Felix-0901/Smart_Home/README.md

# Smart Home

## 專案簡介

這是高中專題延伸整理的智慧家庭專案。專案目標是讓 K、M、P、R、T 多條硬體產品線收集資料，透過後端寫入 PostgreSQL，再由 App 綁定產品、查看即時與歷史資料，並控制 P 系列智慧插座。

目前階段已包含後端 API、MQTT bridge、硬體韌體整理、React Native / Expo App 與 Homi APP Agent 工具層。

## 功能列表

- 硬體感測資料上傳到後端
- 後端接收、驗證並寫入 PostgreSQL
- APP 註冊登入與 JWT / refresh token
- 透過產品編號綁定 Demo 裝置
- APP 查看即時資料與歷史資料
- APP 控制 P 系列智慧插座 relay
- Homi Agent 可透過受控 action 協助導頁、查詢數據、設定裝置、管理房屋空間、切換偏好、聚焦插座並直接送出 relay 控制
- 本地使用 Docker 啟動 PostgreSQL 測試環境
- 使用 Adminer 或 Docker 內的 `psql` 查看資料庫內容
- 硬體程式碼集中放在 `hardware/`

## 技術架構

- App：放在 `app/`，使用 React Native / Expo + TypeScript + Expo Router，可用 Expo Web 匯出成靜態網站部署
- 後端：放在 `backend/`，使用 Node.js + TypeScript API 服務
- 資料庫：PostgreSQL
- MQTT：Mosquitto，供 P 系列智慧插座接收開關指令與回報狀態
- AI Agent：後端使用 OpenAI-compatible Chat Completions，APP 只執行後端驗證過的 Homi action
- 本地測試：Docker Compose，包含 APP Web、後端 API、PostgreSQL、Mosquitto、Adminer
- APP Web 部署：`app/Dockerfile` 使用 Expo Web build，Nginx 提供靜態檔與 SPA fallback
- 資料庫檢視：Adminer、Docker 內建 `psql`
- 硬體韌體：放在 `hardware/`，後續依板子型號選擇 Arduino CLI、PlatformIO 或廠商工具

## 專案結構

```text
.
├── AGENTS.md
├── README.md
├── app/
├── backend/
├── docs/
├── hardware/
├── infra/
├── docker-compose.yml
└── .env.example
```

## 本地測試教學

先確認 Docker Desktop 已啟動，然後在專案根目錄執行：

```bash
docker compose up -d
```

查看容器狀態：

```bash
docker compose ps
```

後端 API 本地網址：

```text
http://localhost:3003
```

APP Web 本地網址：

```text
http://localhost:3004
```

確認後端與資料庫連線：

```bash
curl http://localhost:3003/health
```

建立 APP 使用者系統與 Demo 裝置需要的資料表：

```bash
cd backend
npm install
npm run db:setup
npm run db:seed-demo-devices
```

若要用 iOS Simulator 啟動 APP：

```bash
cd ../app
npm install
npm run ios
```

若要確認 APP Web production build：

```bash
cd ../app
npm run build:web
```

停止本地服務：

```bash
docker compose down
```

若要連進 PostgreSQL：

```bash
docker compose exec postgres psql -U smart_home -d smart_home
```

進入 `psql` 後常用指令：

```sql
\dt
\d table_name
SELECT * FROM table_name LIMIT 20;
\q
```

若偏好網頁介面，啟動 Docker 後開啟：

```text
http://localhost:8080
```

Adminer 登入資訊：

```text
System: PostgreSQL
Server: postgres
Username: smart_home
Password: smart_home_password
Database: smart_home
```

時間欄位使用台灣時間 `Asia/Taipei` 顯示。`received_at` 保留 PostgreSQL 的 `TIMESTAMPTZ` 型別，方便正確排序與比較；本地 Docker 與後端連線會把時區設為 `Asia/Taipei`，所以查詢時會看到 `+08`。

## 環境變數

環境變數範本放在 `.env.example`。目前 Docker Compose 已設定預設值，所以沒有 `.env` 也可以啟動。

實際開發時可以複製一份 `.env`：

```bash
cp .env.example .env
```

不要提交真正的 `.env`、Token、密碼或憑證。

## Coolify 部署教學

後端已提供 `backend/Dockerfile`，APP Web 已提供 `app/Dockerfile`。若使用根目錄 `docker-compose.yml` 部署，Coolify 會同時建立 APP Web、後端、PostgreSQL、Mosquitto 與 Adminer 服務。

正式部署時建議至少設定兩個公開 domain：

```text
APP Web：https://你的 APP 網域
Backend API：https://你的 API 網域
```

APP Web 的 `EXPO_PUBLIC_API_BASE_URL` 是 build-time 變數，Coolify 重新設定後需要重新 build APP image。正式部署時至少需要設定：

```text
APP_PORT=3004
EXPO_PUBLIC_API_BASE_URL=https://你的 API 網域
DATABASE_URL=postgresql://...
DEVICE_API_TOKEN=正式硬體上傳用 token
CORS_ORIGIN=https://你的 APP 網域
APP_PUBLIC_URL=https://你的 API 網域
APP_JWT_SECRET=至少 32 字元的 APP JWT secret
APP_ACCESS_TOKEN_TTL_SECONDS=900
APP_REFRESH_TOKEN_TTL_DAYS=30
APP_INVITE_CODE=Smart_Home
MQTT_BROKER_URL=mqtt://你的 MQTT broker:1883
AI_ENABLED=true
AI_PROVIDER=openai_compatible
AI_BASE_URL=https://你的 AI endpoint
AI_API_KEY=正式 AI key
AI_MODEL=gpt-5.4
```

不要在正式環境使用 `.env.example` 內的本地預設密碼、token 或 JWT secret。Adminer 只建議本地或內網短暫排錯使用，正式部署不要綁定公開 domain。

正式 domain 確定後，硬體程式碼會把資料上傳到：

```text
https://你的固定 API domain/api/series/{seriesKey}/readings
```

## 前端 / 後端詳細文件連結

- [後端文件](backend/README.md)
- [App 文件](app/README.md)
- [整合規劃文件](docs/README.md)
- [硬體文件](hardware/README.md)
