Felix-0901/Smart_Home/docs/README.md

# Docs

## 模組簡介

`docs/` 用來放跨硬體系列、後端、資料庫與部署流程的補充規劃文件。單一系列的接線、測試結果與燒錄方式仍維護在各自的 `hardware/{series_key}/README.md`。

## 文件列表

- [硬體系列整合規劃](hardware-integration-plan.md)

## 維護原則

- 規劃文件使用繁體中文。
- 不記錄 WiFi 密碼、Token、憑證或正式連線字串。
- 硬體實測結果仍以各系列 README 的變更紀錄為準。
- 若規劃改動會影響腳位、狀態燈、上傳欄位或後端 API，需同步更新相關 README。
