Felix-0901/Smart_Home/(commit log)

2026-05-15 chore: 初始化智慧家庭專案
2026-05-31 feat(m-series): 新增 M 系列硬體測試程式
2026-05-31 feat: 整合硬體系列與 MQTT 後端
2026-06-05 feat(app): 新增智慧家庭 APP 與 APP API
2026-06-05 style(app): 優化底部導航列玻璃效果
2026-06-05 feat(app): 完善帳號管理與互動細節
2026-06-05 feat(app): 優化助理介面與首頁插座清單
2026-06-05 fix(app): 修正助理輸入框自動增高
2026-06-06 feat(agent): 完善 Homi 操作與游標
2026-06-06 feat(deploy): 新增 Coolify 網頁部署與展示邀請碼
2026-06-06 fix(deploy): 修正後端 Docker 建置依賴安裝
2026-06-06 fix(deploy): 補齊後端容器健康檢查工具
2026-06-06 fix(app): 修復 Homi 操作游標顯示
2026-06-06 feat(api): 補齊邀請碼裝置一個月模擬資料
2026-06-06 feat(api): 新增裝置預設暱稱遞增規則
2026-06-06 fix(api): 防止同帳號裝置暱稱重複
